IDD-su18/hw2-jasonxzhou/hw2/misc documents/schematic.pdf

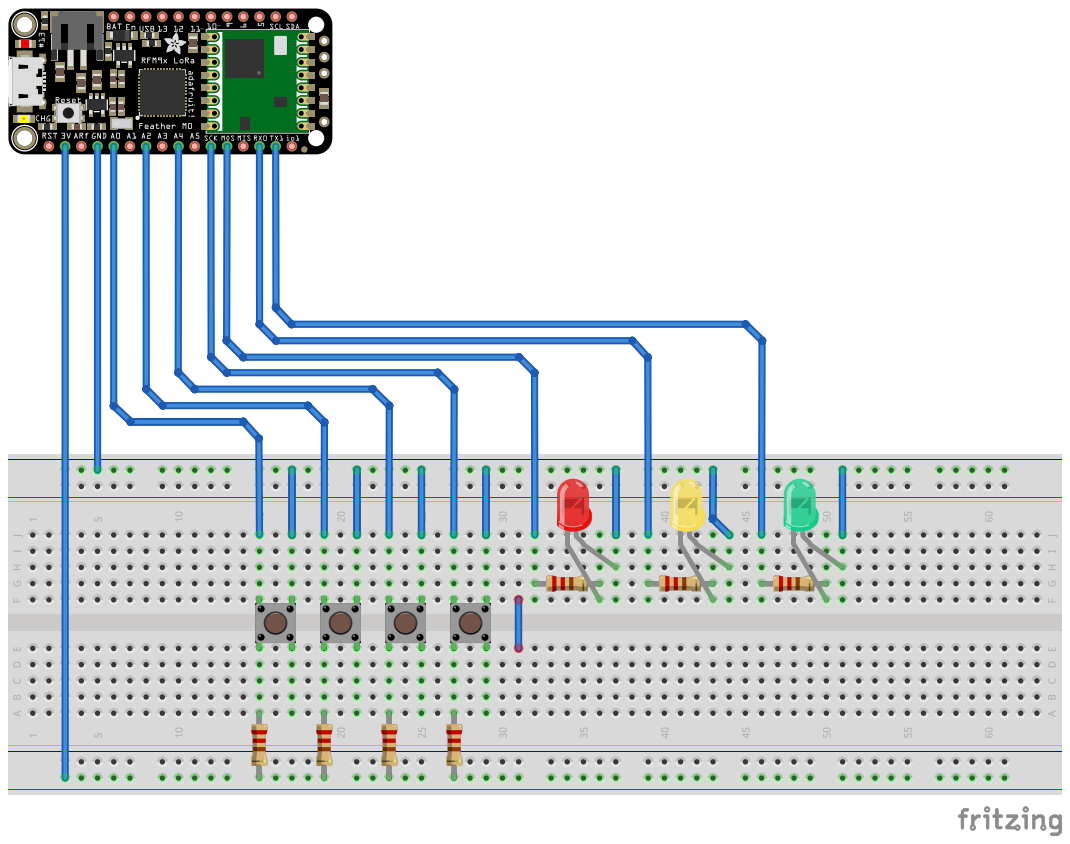
[picture p14: page 1]
