IDD-su18/hw2-jasonxzhou/(commit log)

2018-06-15 adding error handling i.e. when more than 5 bits entered
    [hw2.ino]
2018-06-15 added more error handling - overflow and unrecognized bit pattern, device able to enter in all lowercase characters plus space
    [hw2.ino]
2018-06-19 added LED features + more optimization on error handling
    [hw2.ino]
2018-06-19 schematic finished
2018-06-20 new schematic/error fixed, code pin remap for perfboard
    [hw2.ino]
2018-06-20 added perf board test, fixed code, starting writeup/submission
    [hw2.ino, hw2_perf_board_test.ino]
